enbarberis/ARM9TDMI/README.md

# ARM9TDMI
## Introduction
This project was created with the goal to obtain a “softcore” processor based on the ARM9TDMI architecture.
The work was created as a final project for the course “Microelectronic System” taught at Politecnico di Torino by professor Graziano.
The project was developed by:
* Barberis Enrico
* Canessa Emanuele
* Cipolletta Antonio
* Ciraci Alessandro
## What was done
### Architecture
A first step of reverse engineering to extract inner details of the architecture was done by reading documentation provided by ARM. All the obtained informations are reported in these documents to help future readers:
* `doc/datapath.eps` : an high level datapath view of the processor. This diagram helps to visualize the main blocks that compose the processor.
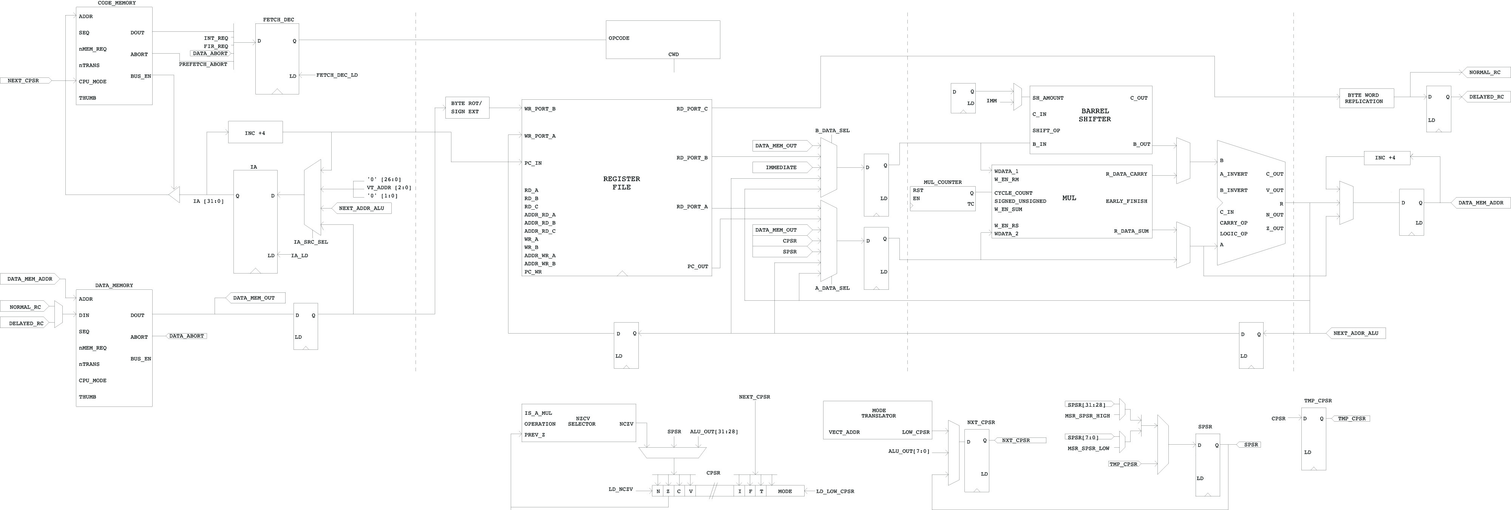
[picture p1: doc/datapath.jpg]
ARM9TDMI datapath

* `doc/ARM9TDMI_datapath_notes.pdf` : this document explain some architecture details of the processor and gives specificaiton about the main processor modules.
* `doc/ARM9TDMI_architecure_notes.pdf` : a document that explain for each instruction encoding, timing and implementation details. This document contains all the information obtained during the architecture definition of the processor.
* `doc/references/` : collection of useful references found on the web. Also the book "ARM System-on-Chip Architecture" by Steve Furber was used.

All the architectural decisions were taken by looking at the cycle count of each instruction reported in the manual in order to obtain a processor with the same timing capabilities of the ARM9TDMI.
### Implementation
After the definition of the architecture a VHDL description of the processor was performed. All the sources are available in the folder `src/`. All the files are contained in the following sub folders:
* `generic` : contains essential components like registers, flip flop and multiplexers.
* `packs` : contains type and constant definition used in other sources. It also contains the functions used by the shifter.
* `fetch` : contains the blocks that implements the fetch stage of the processor.
* `decode` : contains the register file and all the control unit of the processor
* `execute` : contains all the datapath blocks that performs the processor arithmetic or logical operations.
* `memory` : contains simple memory models description for the instruction and data memory. Notice that are used only for simulation purposes. The `utils` folder contains some images and script to convert binary files in text file that can be read by a VHDL simulator.
* `testbench` contains some testbench of sub components and the processor itself.

### Emulation system
At a certain point of the development process crop out the need for a test suite of programs written in assembly. 
In order to test the correctness of the programs that will be used to functionaly verify the processor an emulation system based on QEMU has been setup. All the files you will need to emulate the arm system are available in the folder `arm_emulation`. 
#### Some tips:
* A very simple makefile has been provided. It includes also the directives to translate the executable file from the ELF file to a pure binary.
* A script bash to create the binary flash file needed
* [VERY GOOD REFERENCE](http://www.bravegnu.org/gnu-eprog/index.html#intro)
#### What do you need?
* [GCC toolchain for arm system](https://developer.arm.com/open-source/gnu-toolchain/gnu-rm/downloads)
* QEMU and in particular 'qemu-system-arm'

### Testing
A simple testbench of the processor is available in the folder `src/testbench`. In order to feed easily instruction to the processor a makefile was created to generate a binary file starting from .c or .S sources. All these utilities are available in the folder `arm_emulation`.

## What’s left to do
The entire processor architecture is defined and instantiated, however the file `src/decode/decode_table.vhd` is not complete. Only the data processing operations and single/multiple load/store are defined. In order to have a full compliant processor all the remaining instruction must be defined. It has to been noticed that the control unit FSM is also already defined so the remaining work is merely an OPCODE check and a control word generation.
