enbarberis/ARM9TDMI/doc/references/ARM_Datapath_Simplified.png

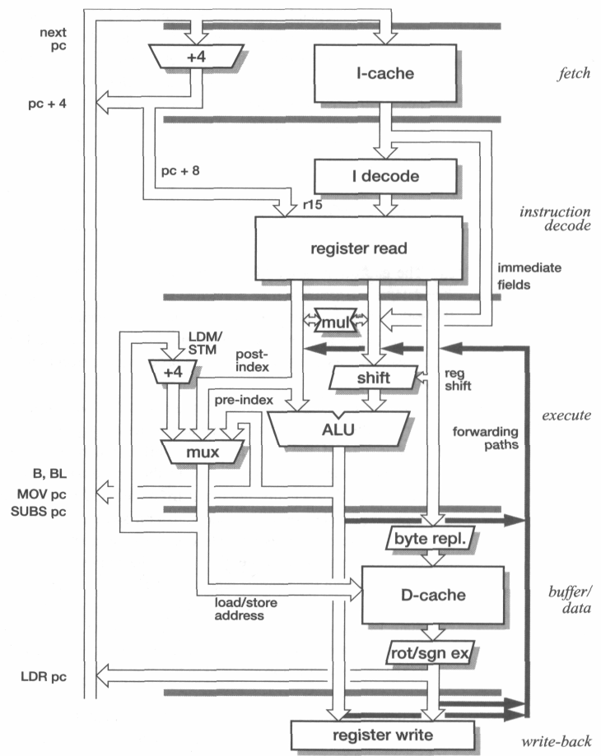
doc/references/ARM_Datapath_Simplified.png
