enbarberis/ARM9TDMI/src/execute/ALU/adder/carry_generator/general_pg.vhd

library ieee;
use ieee.std_logic_1164.all;


entity general_pg is
  port(
        G_ik: in std_logic;
        P_ik: in std_logic;
        G_k_1_j: in std_logic;
        P_k_1_j: in std_logic;
        P_ij: out std_logic;
        G_ij: out std_logic
      );
end entity general_pg;


architecture behavioral of general_pg is
begin

  G_ij <= G_ik or (G_k_1_j and P_ik);
  P_ij <= P_ik and P_k_1_j;

end behavioral;
