enbarberis/ARM9TDMI/src/execute/ALU/adder/sum_generator/iv.vhd

library IEEE;
use IEEE.std_logic_1164.all; --  libreria IEEE con definizione tipi standard logic

entity IV is
	Port (	A:	In	std_logic;
		Y:	Out	std_logic);
end IV;


architecture BEHAVIORAL of IV is

begin
  Y <= not(A);
end BEHAVIORAL;

configuration CFG_IV_BEHAVIORAL of IV is
  for BEHAVIORAL
  end for;
end CFG_IV_BEHAVIORAL;
