enbarberis/ARM9TDMI/(commit log)

2017-09-02 New Readme and new arm emulation folder
2017-10-20 fixed problem on control unit
    [decode_table.vhd]
2017-10-20 data transfer operation fix bug on immediate addressing mode. It was missing the x2 in the ror_amount
    [decode_table.vhd]
2018-01-21 Issue related to the generation of STALL in FORWARDING_UNIT and signal en_rdA generated by the decode_table (not the FSM), before and AND operation with not(stall) but it can be delayed after
    [DFF.vhd, D_FF.vhd, LOAD_REG_NEGEDGE_GEN.vhd, REG_NEGEDGE_GEN.vhd, REG_NEGEDGE_GEN_ACTIVE.vhd, SHIFT_FUNCTION_pack.vhd, carry_select_reduced.vhd, control_unit.vhd]
2018-02-12 Added trace print
    [_vhdl.psm, arch1.psm, behavior.psm, behavioral.psm, behavioral_1.psm, behavioral_2.psm, behavioral_3.psm, bhe.psm]
